adafruit/Adafruit-EYESPI-BFF-PCB/Adafruit EYESPI BFF PCB.brd

## EAGLE design Adafruit EYESPI BFF PCB.brd (2023-06-26)

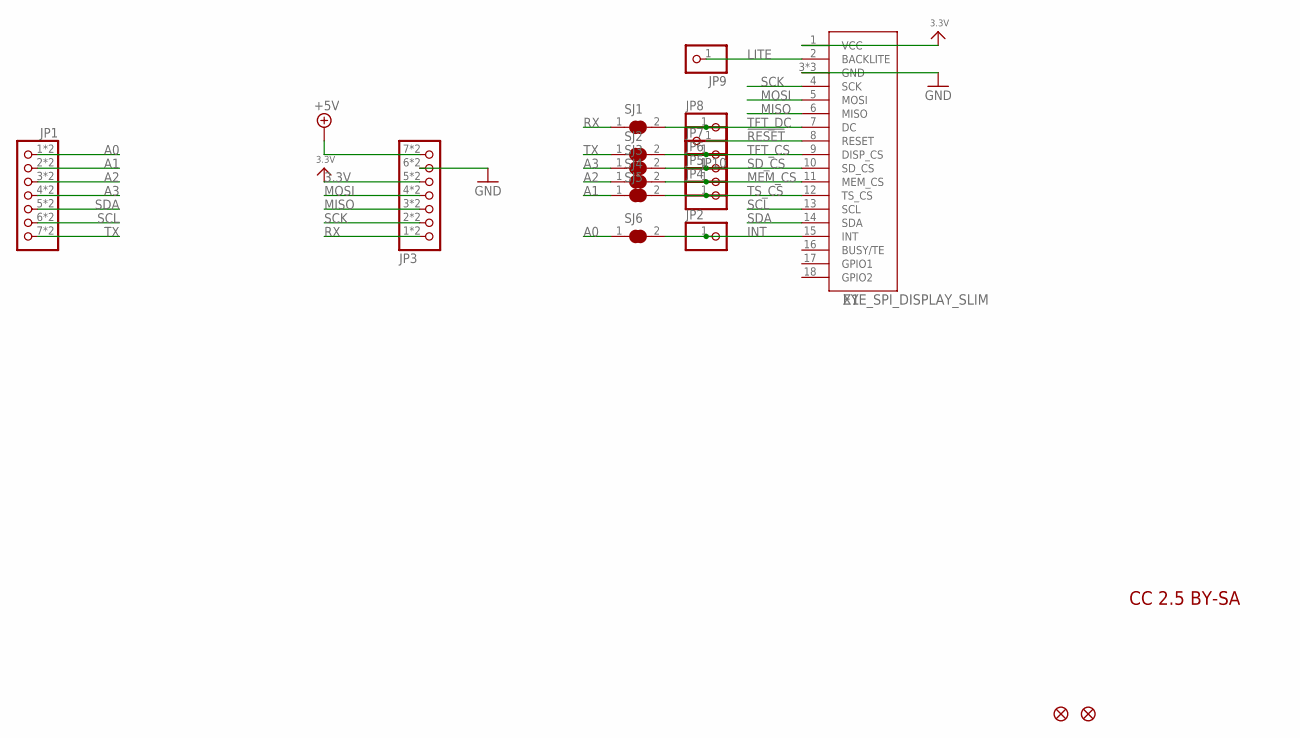
[picture p2: schematic Adafruit EYESPI BFF PCB.sch]

Parts:
JP1, JP3: HEADER-1X7_CASTEL; 1X07_CASTEL
JP2, JP4, JP5, JP6, JP7, JP8, JP9, JP10: HEADER-1X12MM; 1X01_2MM
SJ1, SJ2, SJ3, SJ4, SJ5, SJ6: SOLDERJUMPER_CLOSED; SOLDERJUMPER_CLOSEDWIRE
U$6, U$8: FIDUCIAL_1MM
X1: EYE_SPI_DISPLAY_SLIM

Connections:
3.3V: JP3.5, JP3.5C (5), X1.1 (VCC)
!RESET: JP10.1, X1.8 (RESET)
+5V: JP3.7, JP3.7C (7)
A0: JP1.1, JP1.1C (1), SJ6.1
A1: JP1.2, JP1.2C (2), SJ5.1
A2: JP1.3, JP1.3C (3), SJ4.1
A3: JP1.4, JP1.4C (4), SJ3.1
GND: JP3.6, JP3.6C (6), X1.3 (GND), X1.SUPPORT1 (GND), X1.SUPPORT2 (GND)
INT: JP2.1, SJ6.2, X1.15 (INT)
LITE: JP9.1, X1.2 (BACKLITE)
MEM_CS: JP5.1, SJ4.2, X1.11 (MEM_CS)
MISO: JP3.3, JP3.3C (3), X1.6 (MISO)
MOSI: JP3.4, JP3.4C (4), X1.5 (MOSI)
RX: JP3.1, JP3.1C (1), SJ1.1
SCK: JP3.2, JP3.2C (2), X1.4 (SCK)
SCL: JP1.6, JP1.6C (6), X1.13 (SCL)
SDA: JP1.5, JP1.5C (5), X1.14 (SDA)
SD_CS: JP6.1, SJ3.2, X1.10 (SD_CS)
TFT_CS: JP7.1, SJ2.2, X1.9 (DISP_CS)
TFT_DC: JP8.1, SJ1.2, X1.7 (DC)
TS_CS: JP4.1, SJ5.2, X1.12 (TS_CS)
TX: JP1.7, JP1.7C (7), SJ2.1

Notes on the sheet:
CC 2.5 BY-SA

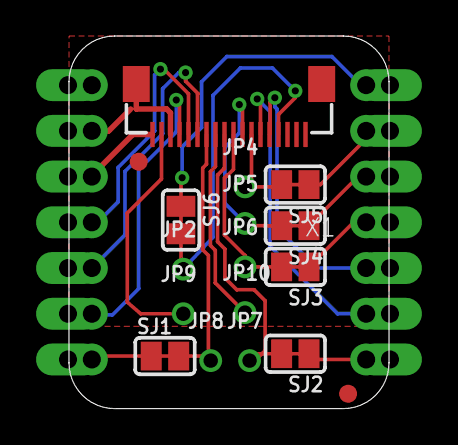
[picture p3: board Adafruit EYESPI BFF PCB.brd from above]

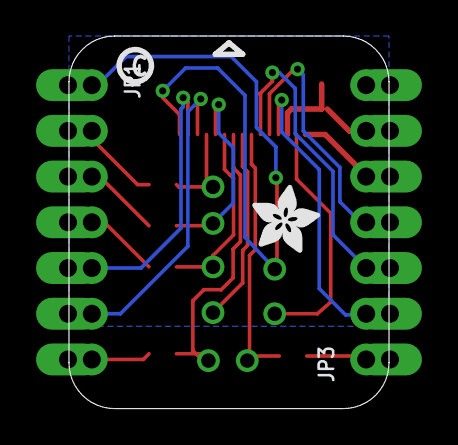
[picture p4: board Adafruit EYESPI BFF PCB.brd from below]

Board: 2 copper layers, 17.8 x 20.7 mm, 54 parts (14 on the bottom side), 22 nets.

Other parts of the board:
PLABEL1: PLABEL1
PLABEL2: PLABEL2
PLABEL3: PLABEL3
PLABEL4: PLABEL4
PLABEL5: PLABEL5
PLABEL6: PLABEL6
PLABEL7: PLABEL7
PLABEL8: PLABEL8
PLABEL9: PLABEL9
PLABEL10: PLABEL10
PLABEL11: PLABEL11
PLABEL12: PLABEL12
PLABEL13: PLABEL13
PLABEL14: PLABEL14
PLABEL19: PLABEL19
PLABEL20: PLABEL20
PLABEL21: PLABEL21
PLABEL22: PLABEL22
PLABEL23: PLABEL23
PLABEL24: PLABEL24
PLABEL25: PLABEL25
PLABEL26: PLABEL26
PLABEL27: PLABEL27
PLABEL28: PLABEL28
PLABEL29: PLABEL29
PLABEL30: PLABEL30
PLABEL31: PLABEL31
PLABEL32: PLABEL32
PLABEL33: PLABEL33
PLABEL34: PLABEL34
PLABEL35: PLABEL35
PLABEL36: PLABEL36
PLABEL37: PLABEL37
U$2: ADAFRUIT_3.5MM
U$3: PCBFEAT-REV-040
